phooky/SMT-for-You-and-Me/VU_board/board/SMT_Soldering_class.kicad_pcb

## KiCad design VU_board/board/SMT_Soldering_class.kicad_pcb (2023-03-22)

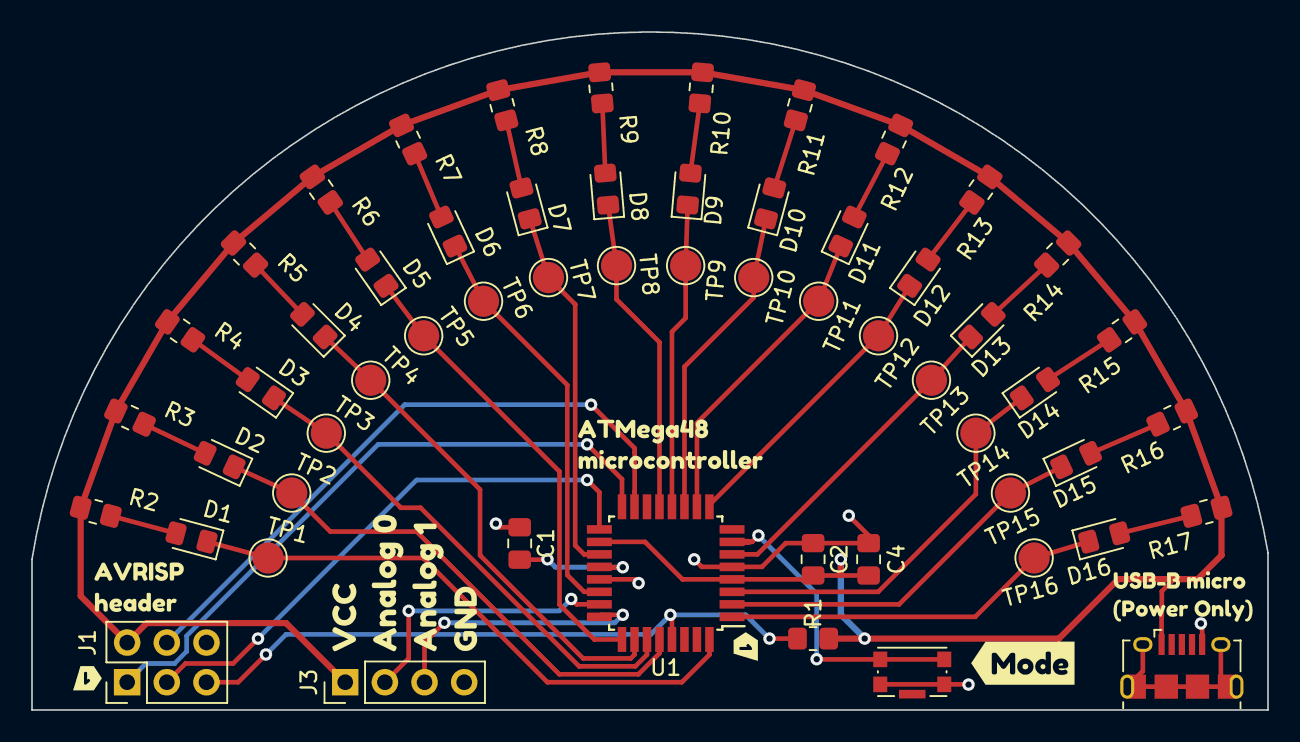
[picture p1: board SMT_Soldering_class.kicad_pcb from above]

Board: 2 copper layers, 79.2 x 43.4 mm, 65 parts (1 on the bottom side), 42 nets.

Parts:
C1, C2: 100nF; C_0805_2012Metric_Pad1.18x1.45mm_HandSolder
C4: 4.7uF; C_0805_2012Metric_Pad1.18x1.45mm_HandSolder
D1, D2, D3, D4, D5, D6, D7, D8, D9, D10, D11, D12, D13, D14, D15, D16: LED; LED_0805_2012Metric_Pad1.15x1.40mm_HandSolder
J1: AVR-ISP-6; PinHeader_2x03_P2.54mm_Vertical
J2: USB_B_Micro; USB_Micro-B_Amphenol_10118194_Horizontal
J3: Conn_01x04; PinHeader_1x04_P2.54mm_Vertical
R1: 4.8K; R_0805_2012Metric_Pad1.20x1.40mm_HandSolder
R2, R3, R4, R5, R6, R7, R8, R9, R10, R11, R12, R13, R14, R15, R16, R17: R; R_0805_2012Metric_Pad1.20x1.40mm_HandSolder
SW1: SW_Push; SW_Push_1P1T-SH_NO_CK_KMR2xxG
TP1, TP2, TP3, TP4, TP5, TP6, TP7, TP8, TP9, TP10, TP11, TP12, TP13, TP14, TP15, TP16: TestPoint; TestPoint_Pad_D2.0mm
U1: ATmega48PB-A; TQFP-32_7x7mm_P0.8mm
kibuzzard-641A1732: G***; kibuzzard-641A1732
kibuzzard-6419EFEB: G***; kibuzzard-6419EFEB
kibuzzard-64037C19: G***; kibuzzard-64037C19
kibuzzard-64037C58: G***; kibuzzard-64037C58
kibuzzard-64037C81: G***; kibuzzard-64037C81
kibuzzard-64037CBD, kibuzzard-64037CBD#2: G***; kibuzzard-64037CBD
kibuzzard-6403760C: G***; kibuzzard-6403760C

Connections:
/ADC0: J3.2, U1.23 (PC0)
/ADC1: J3.3, U1.24 (PC1)
/LED0: D2.1 (K), TP2.1, U1.28 (PC5)
/LED1: D1.1 (K), TP1.1, U1.32 (PD2)
/LED2: D3.1 (K), TP3.1, U1.27 (PC4)
/LED3: D4.1 (K), TP4.1, U1.26 (PC3)
/LED4: D5.1 (K), TP5.1, U1.25 (PC2)
/LED5: D6.1 (K), TP6.1, U1.22 (PE3)
/LED6: D7.1 (K), TP7.1, U1.19 (PE2)
/LED7: D8.1 (K), TP8.1, U1.13 (PB1)
/LED8: D9.1 (K), TP9.1, U1.12 (PB0)
/LED9: D10.1 (K), TP10.1, U1.11 (PD7)
/LED10: D11.1 (K), TP11.1, U1.10 (PD6)
/LED11: D12.1 (K), TP12.1, U1.9 (PD5)
/LED12: D13.1 (K), TP13.1, U1.6 (PE1)
/LED13: D14.1 (K), TP14.1, U1.3 (PE0)
/LED14: D15.1 (K), TP15.1, U1.2 (PD4)
/LED15: D16.1 (K), TP16.1, U1.1 (PD3)
/RESET: J1.5 (~RST), R1.1, U1.29 (~RESET/PC6)
/SCK: J1.3 (SCK), U1.17 (PB5)
/SDI: J1.1 (MISO), U1.16 (PB4)
/SDO: J1.4 (MOSI), U1.15 (PB3)
GND: C1.1, C2.1, C4.2, J1.6 (GND), J2.5 (GND), J3.4, SW1.1, U1.5 (GND), U1.21 (GND)
unnamed: C1.2, U1.20 (AREF)
unnamed: D1.2 (A), R2.2
unnamed: D2.2 (A), R3.2
unnamed: D3.2 (A), R4.2
unnamed: D4.2 (A), R5.2
unnamed: D5.2 (A), R6.2
unnamed: D6.2 (A), R7.2
unnamed: D7.2 (A), R8.2
unnamed: D8.2 (A), R9.2
unnamed: D9.2 (A), R10.2
unnamed: D10.2 (A), R11.2
unnamed: D11.2 (A), R12.2
unnamed: D12.2 (A), R13.2
unnamed: D13.2 (A), R14.2
unnamed: D14.2 (A), R15.2
unnamed: D15.2 (A), R16.2
unnamed: D16.2 (A), R17.2
unnamed: SW1.2, U1.7 (XTAL1/PB6)
VCC: C2.2, C4.1, J1.2 (VCC), J2.1 (VBUS), J3.1, R1.2, R2.1, R3.1, R4.1, R5.1, R6.1, R7.1, R8.1, R9.1, R10.1, R11.1, R12.1, R13.1, R14.1, R15.1, R16.1, R17.1, U1.4 (VCC), U1.18 (AVCC)
