phooky/SMT-for-You-and-Me/(commit log)

2023-03-03 initial checkin w/ crystal
    [SMT_Soldering_class.kicad_pcb, SMT_Soldering_class.kicad_sch, led.kicad_sch]
2023-03-05 version 1.0, march 2023, ready to fab
    [SMT_Soldering_class.kicad_pcb, SMT_Soldering_class.kicad_sch, led.kicad_sch]
2023-03-16 reorganizing repository, adding firmware
    [SMT_Soldering_class.kicad_pcb, SMT_Soldering_class.kicad_sch, led.kicad_sch]
2023-03-16 reorg continues
    [SMT_Soldering_class.kicad_pcb, SMT_Soldering_class.kicad_sch, led.kicad_sch]
2023-03-22 added switch to PCB adding modes to firmware (for old version)
    [SMT_Soldering_class.kicad_pcb, SMT_Soldering_class.kicad_sch, led.kicad_sch]
2023-04-08 adding code to handle button on v2
